xzzWZY/Auto-pet-feeder/README.md

# Intelligent Pet Feeding Machine
## Group member
Ruihan Chen (rhchen@umich.edu),  
Yiran Gu (guyirran@umich.edu),  
Zhiyu Wu (zhiyuwu@umich.edu),  
Zichun Wang (zichunw@umich.edu)  

## Introduction
This is a course project for introduction to embedded system. Our project is to create an Intelligent Pet Feeding Machine, aiming to provide costomers convience to automatically feed the pet, monitor the behavior of pet and give warning.

## Essential Component
Processor:   
		1 Nucleo L4R5ZI-P (stock)  
		1 STMF103C8T6 (order)  
    
Inputs:  
    1 4*4 Keypad (order)  
    3 load cell sensors (order)  
    1 LM335Z thermometer (order)  
    1 HR202L humidity resistance (order)  
    1 Switch (stock)  
    
Outputs:  
    1 NHD-C12864A1Z-FSW-FBW-HTT Graphic oled display (stock)  
    1 H-bridge (stock)  
    1 Parallax Feedback 360° High-Speed Servo (#900-00360)  (stock)  
    1 Peristaltic liquid pump (order)  
    
Other:  
    1 SD card (stock)  
    1 SD card adapter (stock)  
    1 ST Link (order)
