xzzWZY/Auto-pet-feeder/combined-Necleo/combined.ioc

Mcu.UserName=STM32L4R5ZITxP
PA0.Signal=S_TIM2_CH1
PA1.Signal=ADCx_IN6
PA10.Signal=USB_OTG_FS_ID
PA3.Signal=USART2_RX
PA4.Signal=SPI1_NSS
PA5.Signal=SPI1_SCK
PA6.Signal=SPI1_MISO
PA7.Signal=SPI1_MOSI
PA8.Signal=USB_OTG_FS_SOF
PA9.Signal=USB_OTG_FS_VBUS
PB0.Signal=S_TIM3_CH3
PB1.Signal=ADCx_IN16
PB10.Signal=S_TIM2_CH3
PB12.Signal=SAI2_FS_A
PB13.Signal=SAI2_SCK_A
PB14.Signal=S_TIM15_CH1
PB15.Signal=SAI2_SD_A
PB2.Signal=GPIO_Output
PB5.Signal=SPI3_MOSI
PB6.Signal=GPIO_Output
PB7.Signal=S_TIM4_CH2
PB8.Signal=I2C1_SCL
PB9.Signal=I2C1_SDA
PC0.Signal=GPIO_Input
PC1.Signal=GPIO_Output
PC10.Signal=SDMMC1_D2
PC11.Signal=SDMMC1_D3
PC12.Signal=SDMMC1_CK
PC13.Signal=SYS_WKUP2
PC2.Signal=ADCx_IN3
PC3.Signal=ADCx_IN4
PC4.Signal=GPIO_Input
PC5.Signal=GPIO_Output
PC6.Signal=SAI2_MCLK_A
PC7.Signal=S_TIM3_CH2
PC8.Signal=SDMMC1_D0
PC9.Signal=SDMMC1_D1
PD0.Signal=CAN1_RX
PD1.Signal=GPIO_Input
PD14.Signal=S_TIM4_CH3
PD15.Signal=S_TIM4_CH4
PD2.Signal=SDMMC1_CMD
PD3.Signal=USART2_CTS
PD4.Signal=USART2_RTS
PD5.Signal=USART2_TX
PD8.Signal=USART3_TX
PD9.Signal=USART3_RX
PE0.Signal=S_TIM4_ETR
PE10.Signal=TIM1_CH2N
PE11.Signal=S_TIM1_CH2
PE12.Signal=GPIO_Output
PE13.Signal=GPIO_Output
PE14.Signal=GPIO_Output
PE15.Signal=GPIO_Output
PE2.Signal=SAI1_MCLK_A
PE3.Signal=SAI1_SD_B
PE6.Signal=GPXTI6
PE7.Signal=GPXTI7
PE8.Signal=GPXTI8
PE9.Signal=GPXTI9
PF0.Signal=I2C2_SDA
PF1.Signal=I2C2_SCL
PF2.Signal=I2C2_SMBA
PF7.Signal=SAI1_MCLK_B
PG0.Signal=GPIO_Input
PG1.Signal=GPIO_Output
PG7.Signal=LPUART1_TX
PG8.Signal=LPUART1_RX
