xzzWZY/Auto-pet-feeder/f103_SD_card/Core/Src/main.c

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
/* Includes ------------------------------------------------------------------*/
#include "main.h"
#include "fatfs.h"

/* USER CODE BEGIN Includes */
#include <stdio.h>
#include <string.h>
#include <stdbool.h>
#include <stdlib.h>

/* USER CODE END Includes */

/* USER CODE BEGIN PM */
uint8_t UART2_RX_Buffer[32] = {0};
uint8_t read_from_nucleo[32];
char send_to_nucleo_Y1[32];
char send_to_nucleo_Y2[32];
char send_to_nucleo_Y3[32];
char send_to_nucleo_Y4[32];
char send_to_nucleo_Y5[32];
double foodFresh=100;
double waterFresh=100;
int received=0;
int changed_tank=0;
uint8_t send_warning[32];
uint8_t empty[32];
FATFS       FatFs;                //Fatfs handle
FIL         fil;                  //File handle
FRESULT     fres;                 //Result after operations

/* USER CODE END PM */

SPI_HandleTypeDef hspi2;

UART_HandleTypeDef huart1;
DMA_HandleTypeDef hdma_usart1_rx;

void SystemClock_Config(void);
static void MX_GPIO_Init(void);
static void MX_DMA_Init(void);
static void MX_SPI2_Init(void);
static void MX_USART1_UART_Init(void);
/* USER CODE BEGIN PFP */
void example_process_SD_card(void);


FRESULT write_SD_card(
		const uint8_t* wr_text,
	    FIL* fp,            /* [OUT] File object to create */
	    const char* path    /* [IN]  File name to be opened */
);
void get_warning(uint8_t* send_warning);
FRESULT read_last_5_line_SD_card(
		const char* rd_text1,
		const char* rd_text2,
		const char* rd_text3,
		const char* rd_text4,
		const char* rd_text5,
	    FIL* fp,            /* [OUT] File object to create */
	    const char* path    /* [IN]  File name to be opened */
);
FRESULT open_append (
    FIL* fp,            /* [OUT] File object to create */
    const char* path    /* [IN]  File name to be opened */
);
FRESULT read_whole_SD(
		const char* rd_text,
	    FIL* fp,            /* [OUT] File object to create */
	    const char* path    /* [IN]  File name to be opened */
);

/* USER CODE END PFP */

/**
  * @brief  The application entry point.
  * @retval int
  */
int main(void)
{
  /* USER CODE BEGIN 1 */
	for (int i=0; i++; i<32){
		send_warning[i]=0x20; // configure the default character as space characters
	}


//	//delay method
//	for(int i = 0; i < 200; i++){
//		for(int j = 0; j < 1000; j++){}
//	}

  /* USER CODE END 1 */

  /* MCU Configuration--------------------------------------------------------*/

  /* Reset of all peripherals, Initializes the Flash interface and the Systick. */
  HAL_Init();

  /* Configure the system clock */
  SystemClock_Config();

  /* Initialize all configured peripherals */
  MX_GPIO_Init();
  MX_DMA_Init();
  MX_SPI2_Init();
  MX_USART1_UART_Init();
  MX_FATFS_Init();
  /* USER CODE BEGIN 2 */
  HAL_UART_Receive_DMA(&huart1, read_from_nucleo, 32);

  /* USER CODE END 2 */

  /* Infinite loop */
  /* USER CODE BEGIN WHILE */

//	  get_warning(send_warning);

  while (1)
  {
	  if (received==1){
		  get_warning(send_warning); // every time Blue pill receive data from Nulceo, it will recalcuate warning array
		  received=0;
	  }

    /* USER CODE END WHILE */

    /* USER CODE BEGIN 3 */

  }

  /* USER CODE END 3 */
}

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
/* USER CODE BEGIN 4 */
#ifdef __GNUC__
  /* With GCC, small printf (option LD Linker->Libraries->Small printf
     set to 'Yes') calls __io_putchar() */
int __io_putchar(int ch)
#else
int fputc(int ch, FILE *f)
#endif /* __GNUC__ */
{
  /* Place your implementation of fputc here */
  /* e.g. write a character to the UART3 and Loop until the end of transmission */
  HAL_UART_Transmit(&huart1, (uint8_t *)&ch, 1, HAL_MAX_DELAY);
  return ch;
}


void HAL_Delay(__IO uint32_t Delay)
{
//  uint32_t tickstart = 0;
//  uwTick = 65530;   //
//  tickstart = HAL_GetTick();
//  while((HAL_GetTick() - tickstart) < Delay)
//  {
//  }
}

void HAL_UART_RxCpltCallback(UART_HandleTypeDef *huart)
{
	HAL_GPIO_WritePin(GPIOB, GPIO_PIN_0, 0);
	HAL_GPIO_WritePin(GPIOB, GPIO_PIN_1, 0);

	uint8_t ack[32]="Ack456789012345678901234567890\n\0";

	HAL_UART_Transmit(&huart1, ack, 32, 400);
//    HAL_UART_Transmit(&huart1, read_from_nucleo, strlen((char*)read_from_nucleo), 400);
//    HAL_UART_Transmit(&huart1, read_from_nucleo, 32, 400); //32: strlen((char*)read_from_nucleo)
//    HAL_UART_Transmit(&huart1, "\nCallback", strlen("\nCallback"), HAL_MAX_DELAY);


    //Open the file and will write append to the end of the file
	FRESULT fr;
	UINT br, bw;         /* File read/write count */
	char buffer[8];   /* File copy buffer */

	//	fr = open_append(fp, path);

	/* Opens an existing file. If not exist, creates a new file. */
	fr = f_open(&fil, "test.txt",  FA_READ | FA_WRITE | FA_OPEN_ALWAYS);

	if (read_from_nucleo[0]=='*'){ 
		changed_tank=1;
	}
    if (read_from_nucleo[0]=='$'){ // write append SD card
    	uint8_t ack[32]="Ack$ 6789012345678901234567890\n\0";

    	//	write_SD_card(read_from_nucleo,&fil,"test.txt");
    	received=1;
    	if (fr == FR_OK) {
			/* Seek to end of the file to append data */
			fr = f_lseek(&fil, f_size(&fil));
			if (fr != FR_OK)
				f_close(&fil);
		}
		if(fr != FR_OK)
		{
		printf("File creation/open Error : (%i)\r\n", fr);
		}
		printf("Writing data!!!\r\n");
		char char_read_from_nucleo[32];
		for (int i = 0; i < sizeof(read_from_nucleo); i++) {
			char_read_from_nucleo[i] = (char)(read_from_nucleo[i]);
		}
		//write the data
		f_puts(char_read_from_nucleo, &fil);

		//close your file
		f_close(&fil);
    }
    else if (read_from_nucleo[1]=='$'){ // in case that '\0' leads the read_from_nucleo
		//	write_SD_card(read_from_nucleo,&fil,"test.txt");

		if (fr == FR_OK) {
			/* Seek to end of the file to append data */
			fr = f_lseek(&fil, f_size(&fil));
			if (fr != FR_OK)
				f_close(&fil);
		}
		if(fr != FR_OK)
		{
		printf("File creation/open Error : (%i)\r\n", fr);
		}
		printf("Writing data!!!\r\n");
		char char_read_from_nucleo[32];
		for (int i = 1; i < sizeof(read_from_nucleo); i++) {
			char_read_from_nucleo[i-1] = (char)(read_from_nucleo[i]);
		}
		char_read_from_nucleo[31]='\0';
		//write the data
		f_puts(char_read_from_nucleo, &fil);

		//close your file
		f_close(&fil);
	}
    else if (read_from_nucleo[0]=="%"){ // read one line of data (for 1 day) from SD card
    	uint8_t ack[32]="Ack% 6789012345678901234567890\n\0";
		HAL_UART_Transmit(&huart1, send_warning, 32, 400);
	    	HAL_UART_Transmit(&huart1, send_to_nucleo_Y1, 32, 400);
		HAL_UART_Transmit(&huart1, send_to_nucleo_Y2, 32, 400);
		HAL_UART_Transmit(&huart1, send_to_nucleo_Y3, 32, 400);
		HAL_UART_Transmit(&huart1, send_to_nucleo_Y4, 32, 400);
		HAL_UART_Transmit(&huart1, send_to_nucleo_Y5, 32, 400);

    }


    HAL_UART_Receive_DMA(&huart1, read_from_nucleo, 32); // restart the DMA receive
}

void get_warning(uint8_t* send_warning){
	FRESULT fr;
	fr=read_last_5_line_SD_card(send_to_nucleo_Y1,send_to_nucleo_Y2,send_to_nucleo_Y3,send_to_nucleo_Y4,send_to_nucleo_Y5, &fil,"test.txt");

	char tp[4];
	tp[3]='\0';

	float temp1;
	float temp2;
	float temp3;
	float temp4;
	float temp5;

	float humd1;
	float humd2;
	float humd3;
	float humd4;
	float humd5;

	float water1;
	float water2;
	float water3;
	float water4;
	float water5;

	// Calculate to determine if we need to change the WATER or food in tank
	for (int i = 0; i < 3 ; i++) {
		tp[i] = send_to_nucleo_Y1[i+1];
	}
	temp1=(float)(atoi(tp))/10;
	for (int i = 0; i < 3 ; i++) {
		tp[i] = send_to_nucleo_Y2[i+1];
	}
	temp2=(float)(atoi(tp))/10;
	for (int i = 0; i < 3 ; i++) {
		tp[i] = send_to_nucleo_Y3[i+1];
	}
	temp3=(float)(atoi(tp))/10;
	for (int i = 0; i < 3 ; i++) {
		tp[i] = send_to_nucleo_Y4[i+1];
	}
	temp4=(float)(atoi(tp))/10;
	for (int i = 0; i < 3 ; i++) {
		tp[i] = send_to_nucleo_Y5[i+1];
	}
	temp5=(float)(atoi(tp))/10;
// 	float avg_temp=(temp1+temp2+temp3+temp4+temp5)/5;
	
	for (int i = 0; i < 3 ; i++) {
		tp[i] = send_to_nucleo_Y1[i+5];
	}
	humd1=(float)(atoi(tp))/10;
	for (int i = 0; i < 3 ; i++) {
		tp[i] = send_to_nucleo_Y2[i+5];
	}
	humd2=(float)(atoi(tp))/10;
	for (int i = 0; i < 3 ; i++) {
		tp[i] = send_to_nucleo_Y3[i+5];
	}
	humd3=(float)(atoi(tp))/10;
	for (int i = 0; i < 3 ; i++) {
		tp[i] = send_to_nucleo_Y4[i+5];
	}
	humd4=(float)(atoi(tp))/10;
	for (int i = 0; i < 3 ; i++) {
		tp[i] = send_to_nucleo_Y5[i+5];
	}
	humd5=(float)(atoi(tp))/10;
	
	waterFresh = floor((waterFresh - ((temp1 + 40)*(temp1 + 40)/60.0))*10) / 10.0;
	waterFresh = floor((waterFresh - ((temp2 + 40)*(temp2 + 40)/60.0))*10) / 10.0;
	waterFresh = floor((waterFresh - ((temp3 + 40)*(temp3 + 40)/60.0))*10) / 10.0;
	waterFresh = floor((waterFresh - ((temp4 + 40)*(temp4 + 40)/60.0))*10) / 10.0;
	waterFresh = floor((waterFresh - ((temp5 + 40)*(temp5 + 40)/60.0))*10) / 10.0;

	foodFresh = floor((foodFresh - ((temp1 + 40)*(temp1 + 40)*(humd1 + 50) / 20000.0))*10)/10.0;
	foodFresh = floor((foodFresh - ((temp2 + 40)*(temp2 + 40)*(humd2 + 50) / 20000.0))*10)/10.0;
	foodFresh = floor((foodFresh - ((temp3 + 40)*(temp3 + 40)*(humd3 + 50) / 20000.0))*10)/10.0;
	foodFresh = floor((foodFresh - ((temp4 + 40)*(temp4 + 40)*(humd4 + 50) / 20000.0))*10)/10.0;
	foodFresh = floor((foodFresh - ((temp5 + 40)*(temp5 + 40)*(humd5 + 50) / 20000.0))*10)/10.0;
	
	if (foodFresh<0){
		send_warning[0]='T';
	}
	else {
		send_warning[0]='F';
	}
	if (waterFresh<0){
		send_warning[1]='T';
	}
	else {
		send_warning[1]='F';
	}
	if (changed_tank=1){
		if (foodFresh<0){
			foodFresh=100;
		}
		if (waterFresh<0){
			waterFresh=100;
		}
		changed_tank=0;
	}
	
	// Calculate to determine giving DRINGKING too little water WANING
	char tp2[6];
	tp2[5]='\0';
	char tp3[5];
	tp3[4]='\0';
	float pet_weight;
	for (int i = 0; i < 6 ; i++) {
		tp2[i] = send_to_nucleo_Y1[i+19];
	}
	pet_weight=(float)(atoi(tp2))/10;
	float std_drink_water;
	std_drink_water=5*50*pet_weight/1000; //unit is ml

	for (int i = 0; i < 4 ; i++) {
		tp3[i] = send_to_nucleo_Y1[i+14];
	}
	water1=(float)(atoi(tp3))/10;
	for (int i = 0; i < 4 ; i++) {
		tp3[i] = send_to_nucleo_Y2[i+14];
	}
	water2=(float)(atoi(tp3))/10;
	for (int i = 0; i < 4 ; i++) {
		tp3[i] = send_to_nucleo_Y3[i+14];
	}
	water3=(float)(atoi(tp3))/10;
	for (int i = 0; i < 4 ; i++) {
		tp3[i] = send_to_nucleo_Y4[i+14];
	}
	water4=(float)(atoi(tp3))/10;
	for (int i = 0; i < 4 ; i++) {
		tp3[i] = send_to_nucleo_Y5[i+14];
	}
	water5=(float)(atoi(tp3))/10;

	float all_water_drunk=water1+water2+water3+water4+water5;
	if (all_water_drunk<std_drink_water){
		send_warning[2]='T';
	}
	else {
		send_warning[2]='F';
	}
	
	// Calculate to determine giving EATING too MUCH food WANING
	float std_eat_food=pet_weight*0.03;

	float food1;
	for (int i = 0; i < 4 ; i++) {
		tp3[i] = send_to_nucleo_Y1[i+9];
	}
	food1=(float)(atoi(tp3))/10;
	if (food1<std_eat_food){
		send_warning[3]='T';
	}
	else{
		send_warning[3]='F';
	}

	// Calculate to determine giving EATING too LITTLE food WANING
	float stdmore_eat_food=pet_weight*0.05;

	if (food1>stdmore_eat_food){
		send_warning[4]='T';
	}
	else{
		send_warning[4]='F';
	}
	send_warning[5]='\n';
	send_warning[31]='\0';
}

FRESULT read_last_5_line_SD_card(
		const char* rd_text1,
		const char* rd_text2,
		const char* rd_text3,
		const char* rd_text4,
		const char* rd_text5,
		FIL* fp,            /* [OUT] File object to create */
	    const char* path    /* [IN]  File name to be opened */
)
{
	// Mount the SD Card
	fres = f_mount(&FatFs, "", 1);    //1=mount now
	if (fres != FR_OK)
	{
	  printf("No SD Card found : (%i)\r\n", fres);
	}
	//Open the file and will write append to the end of the file
    FRESULT fr;
//    UINT br, bw;         /* File read/write count */


    /* Opens an existing file and read it. */
    fr = f_open(fp, path, FA_READ);
    if (fr == FR_OK) {
        /* Seek to last line of the file to read last line of data */
        fr = f_lseek(fp, f_size(fp)-32);
        if (fr != FR_OK)
            f_close(fp);
    }

	//read the data
    f_gets(rd_text1, 32, fp);

	/* Seek to last 2nd line of the file to read last line of data */
	fr = f_lseek(fp, f_tell(fp)-64);
	if (fr == FR_OK){
		f_gets(rd_text2, 32, fp);
	}

	/* Seek to last 3rd line of the file to read last line of data */
	fr = f_lseek(fp, f_tell(fp)-96);
	if (fr == FR_OK){
		f_gets(rd_text3, 32, fp);
	}

	/* Seek to last 4th line of the file to read last line of data */
	fr = f_lseek(fp, f_tell(fp)-128);
	if (fr == FR_OK){
		f_gets(rd_text4, 32, fp);
	}
	/* Seek to last 5th line of the file to read last line of data */
	fr = f_lseek(fp, f_tell(fp)-160);
	if (fr == FR_OK){
		f_gets(rd_text5, 32, fp);
	}

	//close your file
	f_close(fp);
	//We're done, so de-mount the drive
	f_mount(NULL, "", 0);

	return fr;
}

FRESULT read_whole_SD(
		const char* rd_text,
	    FIL* fp,            /* [OUT] File object to create */
	    const char* path    /* [IN]  File name to be opened */
)
{
	// Mount the SD Card
	fres = f_mount(&FatFs, "", 1);    //1=mount now
	if (fres != FR_OK)
	{
	  printf("No SD Card found : (%i)\r\n", fres);
	}
	//Open the file and will write append to the end of the file
    FRESULT fr;
    UINT br;         /* File read count */


    /* Opens an existing file. If not exist, creates a new file. */
    fr = f_open(fp, path, FA_READ);

	if(fr != FR_OK)
	{
	printf("File creation/open Error : (%i)\r\n", fr);
	}

	printf("Read data!!!\r\n");
	//read the data
//	f_gets(rd_text, sizeof rd_text, fp);
    fr = f_read(fp, rd_text, sizeof rd_text, &br); /* Read a chunk of data from the source file */


	//close your file
	f_close(fp);
	//We're done, so de-mount the drive
	f_mount(NULL, "", 0);

	return fr;
}

FRESULT write_SD_card(
		const uint8_t* wr_text,
	    FIL* fp,            /* [OUT] File object to create */
	    const char* path    /* [IN]  File name to be opened */
)
{
	// Mount the SD Card
	fres = f_mount(&FatFs, "", 1);    //1=mount now
	if (fres != FR_OK)
	{
	  printf("No SD Card found : (%i)\r\n", fres);
	}
	//Open the file and will write append to the end of the file
    FRESULT fr;

//	fr = open_append(fp, path);

    /* Opens an existing file. If not exist, creates a new file. */
    fr = f_open(fp, path, FA_WRITE | FA_OPEN_ALWAYS);
    if (fr == FR_OK) {
        /* Seek to end of the file to append data */
        fr = f_lseek(fp, f_size(fp));
        if (fr != FR_OK)
            f_close(fp);
    }
	if(fr != FR_OK)
	{
	printf("File creation/open Error : (%i)\r\n", fr);
	}

	printf("Writing data!!!\r\n");

	char char_wr_text[32];
	int size=sizeof(wr_text);
	for (int i = 0; i < 32; i++) {
		char_wr_text[i] = (char)(wr_text[i]);
	}
	//write the data
	f_puts(char_wr_text, fp);

	//close your file
	f_close(fp);
	//We're done, so de-mount the drive
	f_mount(NULL, "", 0);
	return fr;
}

/*------------------------------------------------------------/
/ Open or create a file in append mode
/ (This function was sperseded by FA_OPEN_APPEND flag at FatFs R0.12a)
/------------------------------------------------------------*/

FRESULT open_append (
    FIL* fp,            /* [OUT] File object to create */
    const char* path    /* [IN]  File name to be opened */
)
{
    FRESULT fr;

    /* Opens an existing file. If not exist, creates a new file. */
    fr = f_open(fp, path, FA_WRITE | FA_OPEN_ALWAYS);
    if (fr == FR_OK) {
        /* Seek to end of the file to append data */
        fr = f_lseek(fp, f_size(fp));
        if (fr != FR_OK)
            f_close(fp);
    }
    return fr;
}

void example_process_SD_card( void )
{
  FATFS       FatFs;                //Fatfs handle
  FIL         fil;                  //File handle
  FRESULT     fres;                 //Result after operations
  char        buf[100];

  do
  {
    //Mount the SD Card
    fres = f_mount(&FatFs, "", 1);    //1=mount now
    if (fres != FR_OK)
    {
      printf("No SD Card found : (%i)\r\n", fres);
      break;
    }
    printf("SD Card Mounted Successfully!!!\r\n");

    //Read the SD Card Total size and Free Size
    FATFS *pfs;
    DWORD fre_clust;
    uint32_t totalSpace, freeSpace;

    f_getfree("", &fre_clust, &pfs);
//    totalSpace = (uint32_t)((pfs->n_fatent - 2) * pfs->csize * 0.5);
//    freeSpace = (uint32_t)(fre_clust * pfs->csize * 0.5);

    printf("TotalSpace : %lu bytes, FreeSpace = %lu bytes\n", totalSpace, freeSpace);

    //Open the file
    fres = f_open(&fil, "EmbeTronicX.txt", FA_WRITE | FA_READ | FA_CREATE_ALWAYS);
    if(fres != FR_OK)
    {
      printf("File creation/open Error : (%i)\r\n", fres);
      break;
    }

    printf("Writing data!!!\r\n");
    //write the data
    f_puts("Welcome to EmbeTronicX", &fil);

    //close your file
    f_close(&fil);

    //Open the file
    fres = f_open(&fil, "EmbeTronicX.txt", FA_READ);
    if(fres != FR_OK)
    {
      printf("File opening Error : (%i)\r\n", fres);
      break;
    }

    //read the data
    f_gets(buf, sizeof(buf), &fil);

    printf("Read Data : %s\n", buf);

    //close your file
    f_close(&fil);
    printf("Closing File!!!\r\n");
#if 0
    //Delete the file.
    fres = f_unlink(EmbeTronicX.txt);
    if (fres != FR_OK)
    {
      printf("Cannot able to delete the file\n");
    }
#endif
  } while( false );

  //We're done, so de-mount the drive
  f_mount(NULL, "", 0);
  printf("SD Card Unmounted Successfully!!!\r\n");
}


/* USER CODE END 4 */
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
